BenBergman/replacement_kinesis_controller/bom.md

Note: AliExpress links are often for excess quantities or range of values.

Base parts
----------

- ATmega32U4 - 1
    - [Digikey](http://www.digikey.ca/product-search/en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)
- FFC connectors - 4 vertical or 2 vertical and 2 horizontal for older boards
    - [Digikey (non-stock)](http://www.digikey.ca/product-search/en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)
- MCP23018 - 1
    - [Digikey](http://www.digikey.ca/product-search/en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)
- WS2811 "Neopixels" - 4
- 1N4148 (SOD-323) - 12
    - [Digikey](http://www.digikey.ca/product-detail/en/1N4148W-TP/1N4148WTPMSCT-ND/717311)
    - [AliExpress](http://www.aliexpress.com/item/Free-shipping-100PCS-1N4148-SMD-IN4148-0805-SOD-323-Switching-Diode/1578916085.html)
- LEDs - 4
    - [AliExpress](http://www.aliexpress.com/item/120PC-Lot-0805-SMD-LED-light-Package-LED-Package-Red-White-Green-Blue-Yellow-Orange-0805/2022131094.html)
- PTC resettable fuse - 1
    - [DigiKey](http://www.digikey.ca/product-detail/en/0ZCK0050FF2E/507-1813-1-ND/4156255)
- N-FET (BSS138) - 1
    - [DigiKey](http://www.digikey.ca/product-detail/en/BSS138L/BSS138LCT-ND/5044761)
    - [AliExpress](http://www.aliexpress.com/item/Free-shipping-100PCS-BSS138-BSS138LT1G-ON-SOT-23-MOSFET/840686962.html)
- P-FET (SI2303) - 2
    - [DigiKey](http://www.digikey.ca/product-detail/en/SI2303CDS-T1-GE3/SI2303CDS-T1-GE3CT-ND/1978878)
    - [AliExpress](http://www.aliexpress.com/w/wholesale-si2303.html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)
- Reset switch - 2
    - [Digikey](http://www.digikey.ca/product-detail/en/PTS645SM43SMTR92%20LFS/CKN9112CT-ND/1146934)
    - [AliExpress](http://www.aliexpress.com/item/100pcs-5types-Momentary-Tact-Tactile-Push-Button-Switch-SMD-Assortment-Kit-Set/1868693922.html)
- Power switch - 1
    - [AliExpress](http://www.aliexpress.com/item/SS23E04-G6-8-Solder-Lug-Pin-3-Position-2P3T-DP3T-Panel-Mini-Slide-Switch/1738133706.html)
- 3V3 regulator MIC5504 - 1
    - [DigiKey](http://www.digikey.ca/product-search/en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)

Wireless
--------
- Bluegiga WT12 - 1 - [Digikey](http://www.digikey.ca/product-detail/en/WT12-A-AI5/1446-1011-1-ND/4245494)
- 10nH inductor (0805) - 1
    - [AliExpress](http://www.aliexpress.com/item/Free-Shipping-0805-SMD-Inductor-30valuesX20pcs-600pcs-LOT-1NH-22UH-Electronic-Components-Package-Inductor-Assorted-Ki/1795492501.html)
- JST connector - 1
    - [DigiKey](http://www.digikey.ca/product-detail/en/S2B-PH-SM4-TB%28LF%29%28SN%29/455-1749-1-ND/926846)
- MBR0520LT1 - 1
    - [AliExpress](http://www.aliexpress.com/item/Free-Shipping-50PCS-MBR0520-On-Semi-0-5A-20V-Schottky-SOD-123-MBR0520LT-MBR0520LT1-ICs/1891176479.html)
- MCP73832 (lipo charger) - 1
    - [DigiKey](http://www.digikey.ca/product-detail/en/MCP73832T-2ACI%2FOT/MCP73832T-2ACI%2FOTCT-ND/1979805)
