BenBergman/replacement_kinesis_controller/notes.md

LiPo charger info
* [Using voltage to measure remaining capacity](http://electronics.stackexchange.com/questions/39412/measure-lithium-ion-battery-voltage-thus-remaining-capacity)
* [Bypass battery and charger when external supply present](https://forum.sparkfun.com/viewtopic.php?f=20&t=38033)
* [LiPo regulator discussion](http://electronics.stackexchange.com/questions/38782/regulated-3-3v-from-a-lithium-ion-or-lipo-battery)
