BenBergman/replacement_kinesis_controller/replacement_kinesis_controller.kicad_pcb

## KiCad design replacement_kinesis_controller.kicad_pcb (2015-03-22)

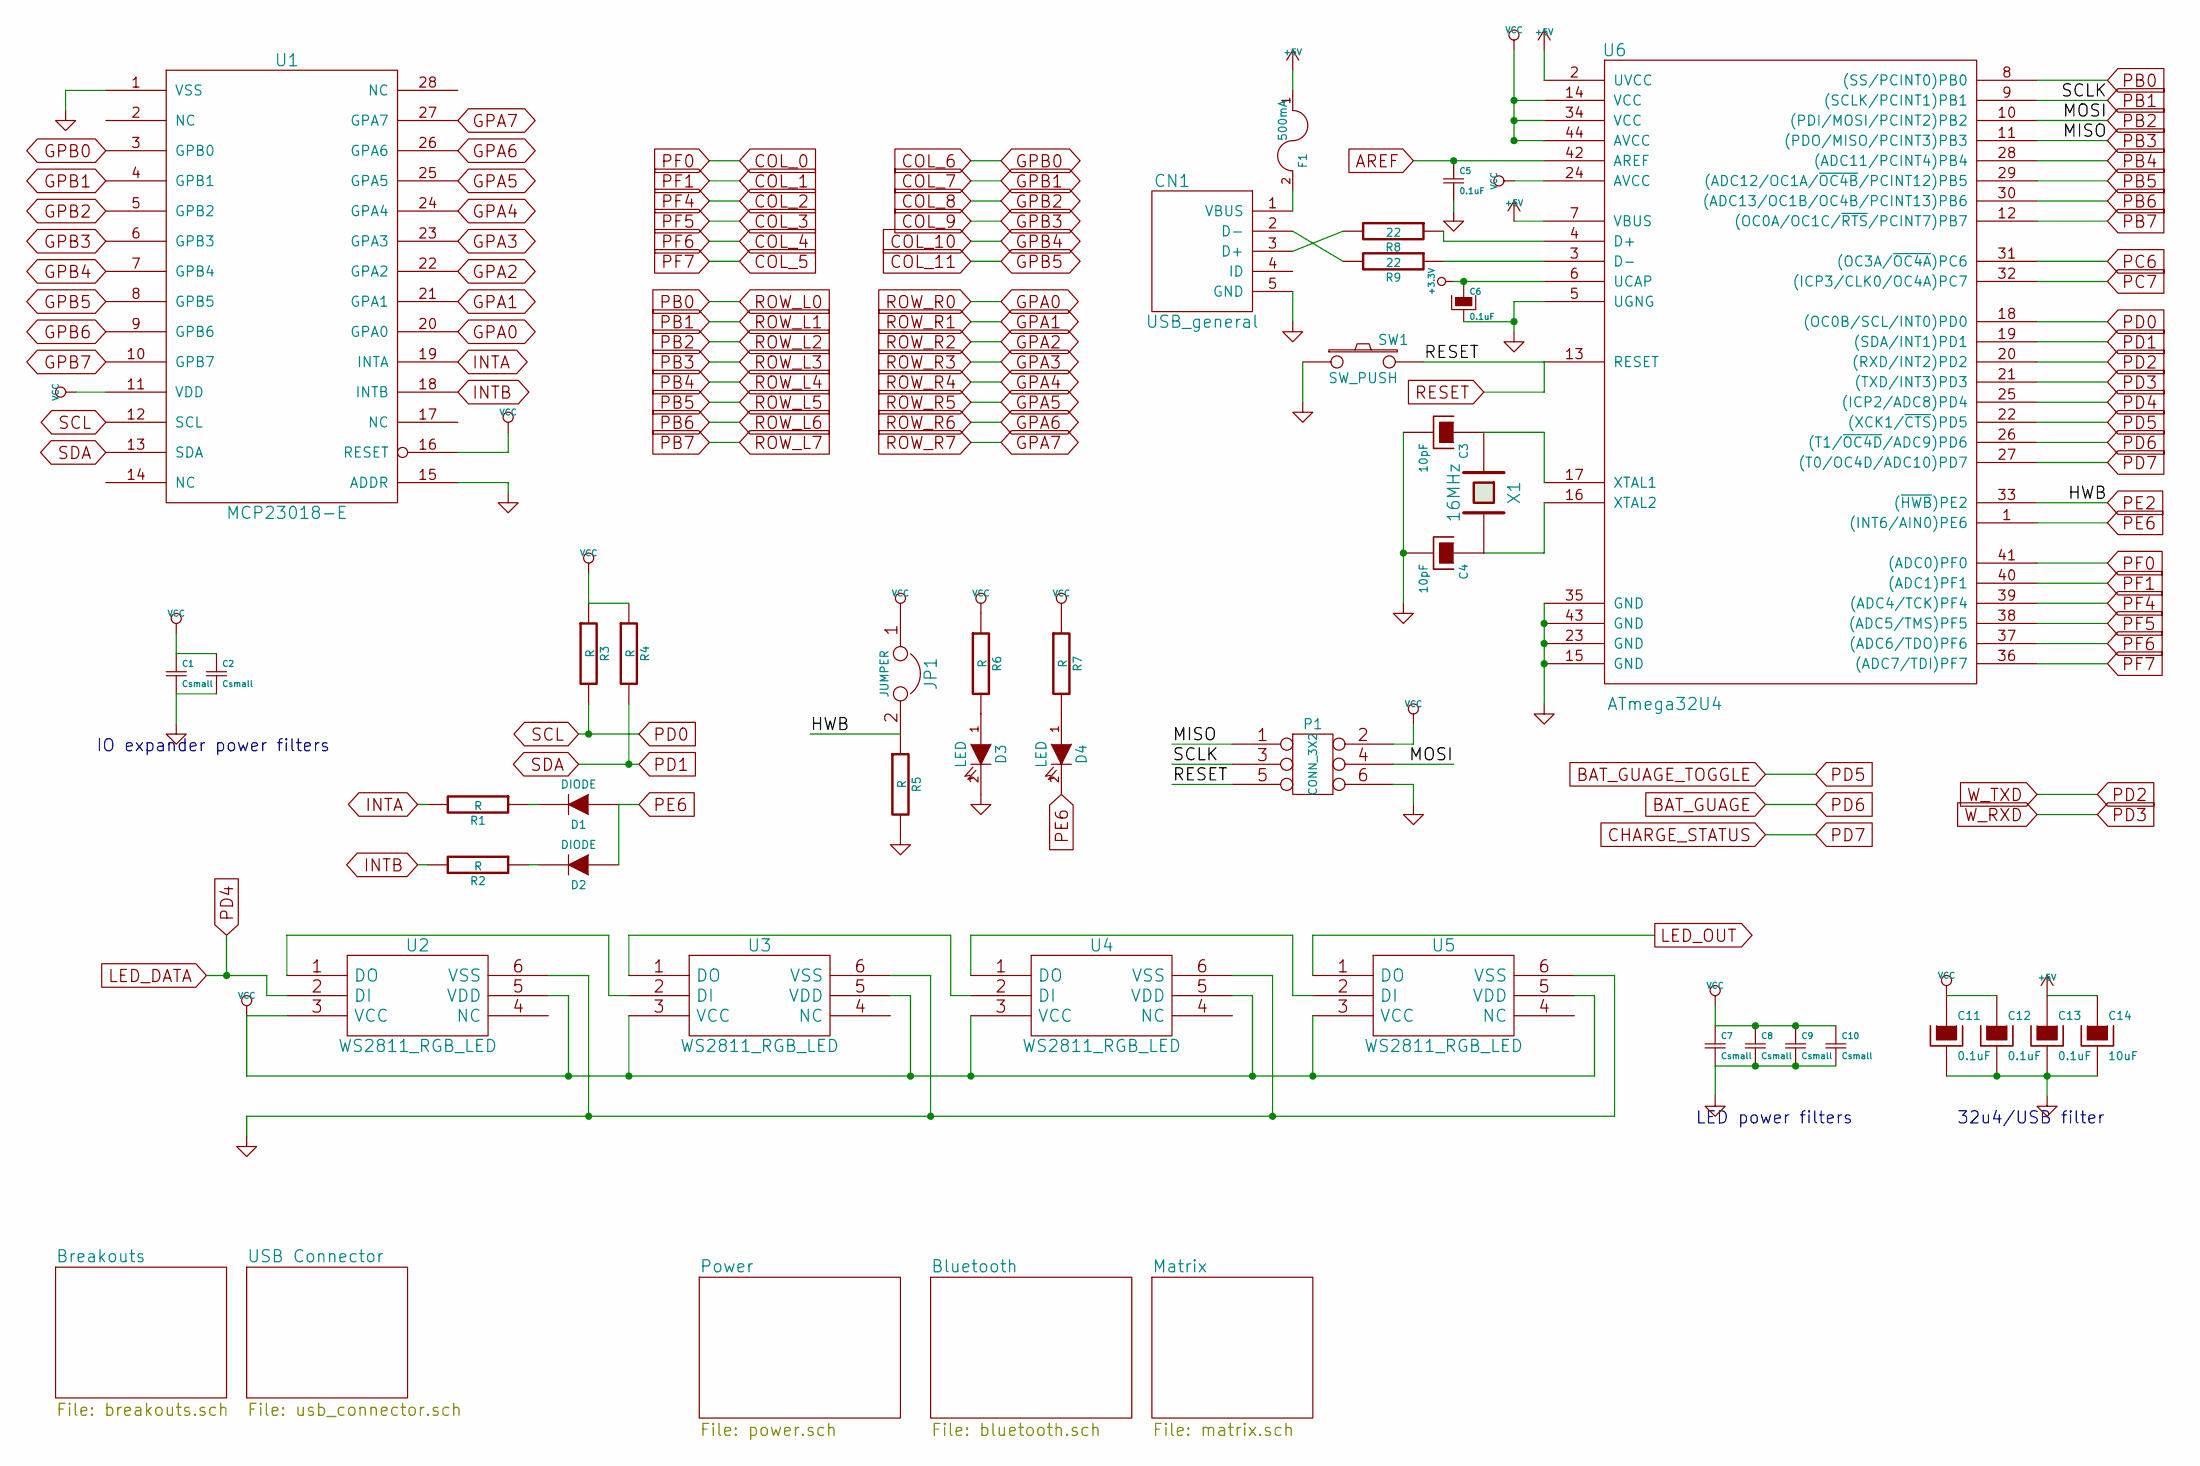
[picture p1: schematic replacement_kinesis_controller.sch, Kinesis Contoured Bluetooth Controller]

Parts:
C1, C2, C7, C8, C9, C10: Csmall; C_0805_HandSoldering
C3, C4: 10pF; C_0805_HandSoldering
C5, C6, C11, C12, C13: 0.1uF; C_0805_HandSoldering
C14: 10uF; C_0805_HandSoldering
CN1: USB_general; Pin_Header_Staggered_Straight_1x05
D1, D2: DIODE; SOD-323_Handsolder
D3, D4: LED; LED-0805
F1: 500mA; R_0805_HandSoldering
JP1: JUMPER; JUMPER_2
P1: CONN_3X2; Pin_Header_Staggered_Straight_2x03
R1, R2, R3, R4, R5, R6, R7: R; R_0805_HandSoldering
R8, R9: 22; R_0805_HandSoldering
SW1: SW_PUSH; SW_SPST_PTS645
U1: MCP23018-E; SOIC-28
U2, U3, U4, U5: WS2811_RGB_LED; LED_RGB_WS2811
U6: ATmega32U4; TQFP-44_10x10mm_Pitch0.8mm
X1: 16MHz; Crystal_HC49-SD_SMD

Connections:
+3.3V: C6.1, U6.6 (UCAP); also elsewhere on the board
+5V: C13.1, C14.1, F1.1, U6.2 (UVCC), U6.7 (VBUS); also elsewhere on the board
AREF: C5.1, U6.42 (AREF); also elsewhere on the board
BAT_GUAGE: U6.26 ((T1/~OC4D~/ADC9)PD6); also elsewhere on the board
BAT_GUAGE_TOGGLE: U6.22 ((XCK1/~CTS~)PD5); also elsewhere on the board
COL_0: U6.41 ((ADC0)PF0); also elsewhere on the board
COL_2: U6.39 ((ADC4/TCK)PF4); also elsewhere on the board
COL_5: U6.36 ((ADC7/TDI)PF7); also elsewhere on the board
COL_6: U1.3 (GPB0); also elsewhere on the board
COL_7: U1.4 (GPB1); also elsewhere on the board
COL_8: U1.5 (GPB2); also elsewhere on the board
COL_11: U1.8 (GPB5); also elsewhere on the board
GND: C1.2, C2.2, C3.2, C4.2, C5.2, C6.2, C7.2, C8.2, C9.2, C10.2, C11.2, C12.2, C13.2, C14.2, CN1.5 (GND), D3.2 (K), P1.6, R5.2, SW1.1, U1.1 (VSS), U1.15 (ADDR), U2.6 (VSS), U3.6 (VSS), U4.6 (VSS), U5.6 (VSS), U6.5 (UGNG), U6.15 (GND), U6.23 (GND), U6.35 (GND), U6.43 (GND); also elsewhere on the board
GPA3: U1.23 (GPA3); also elsewhere on the board
GPA5: U1.25 (GPA5); also elsewhere on the board
GPA6: U1.26 (GPA6); also elsewhere on the board
GPA7: U1.27 (GPA7); also elsewhere on the board
GPB3: U1.6 (GPB3); also elsewhere on the board
GPB4: U1.7 (GPB4); also elsewhere on the board
GPB6: U1.9 (GPB6); also elsewhere on the board
GPB7: U1.10 (GPB7); also elsewhere on the board
INTA: R1.2, U1.19 (INTA)
INTB: R2.2, U1.18 (INTB)
LED_OUT: U5.1 (DO); also elsewhere on the board
unnamed: C3.1, U6.17 (XTAL1), X1.1
unnamed: C4.1, U6.16 (XTAL2), X1.2
unnamed: CN1.1 (VBUS), F1.2
unnamed: CN1.2 (D-), R9.2
unnamed: CN1.3 (D+), R8.2
unnamed: D1.2 (K), R1.1
unnamed: D2.2 (K), R2.1
unnamed: D3.1 (A), R6.2
unnamed: D4.1 (A), R7.2
unnamed: R8.1, U6.4 (D+)
unnamed: R9.1, U6.3 (D-)
unnamed: U2.1 (DO), U3.2 (DI)
unnamed: U3.1 (DO), U4.2 (DI)
unnamed: U4.1 (DO), U5.2 (DI)
PB1: P1.3, U6.9 ((SCLK/PCINT1)PB1); also elsewhere on the board
PB2: P1.4, U6.10 ((PDI/MOSI/PCINT2)PB2); also elsewhere on the board
PB3: P1.1, U6.11 ((PDO/MISO/PCINT3)PB3); also elsewhere on the board
PB4: U6.28 ((ADC11/PCINT4)PB4); also elsewhere on the board
PB5: U6.29 ((ADC12/OC1A/~OC4B~/PCINT12)PB5); also elsewhere on the board
PB6: U6.30 ((ADC13/OC1B/OC4B/PCINT13)PB6); also elsewhere on the board
PB7: U6.12 ((OC0A/OC1C/~RTS~/PCINT7)PB7); also elsewhere on the board
PC6: U6.31 ((OC3A/~OC4A~)PC6); also elsewhere on the board
PC7: U6.32 ((ICP3/CLK0/OC4A)PC7); also elsewhere on the board
PD0: R3.2, U1.12 (SCL), U6.18 ((OC0B/SCL/INT0)PD0); also elsewhere on the board
PD3: U6.21 ((TXD/INT3)PD3); also elsewhere on the board
PD7: U6.27 ((T0/OC4D/ADC10)PD7); also elsewhere on the board
PE2: JP1.2, R5.1, U6.33 ((~HWB~)PE2)
PE6: D1.1 (A), D2.1 (A), D4.2 (K), U6.1 ((INT6/AIN0)PE6); also elsewhere on the board
PF1: U6.40 ((ADC1)PF1); also elsewhere on the board
PF5: U6.38 ((ADC5/TMS)PF5); also elsewhere on the board
PF6: U6.37 ((ADC6/TDO)PF6); also elsewhere on the board
RESET: P1.5, SW1.2, U6.13 (RESET); also elsewhere on the board
ROW_L0: U6.8 ((SS/PCINT0)PB0); also elsewhere on the board
ROW_R0: U1.20 (GPA0); also elsewhere on the board
ROW_R1: U1.21 (GPA1); also elsewhere on the board
ROW_R2: U1.22 (GPA2); also elsewhere on the board
ROW_R4: U1.24 (GPA4); also elsewhere on the board
SDA: R4.2, U1.13 (SDA), U6.19 ((SDA/INT1)PD1); also elsewhere on the board
VCC: C1.1, C2.1, C7.1, C8.1, C9.1, C10.1, C11.1, C12.1, JP1.1, P1.2, R3.1, R4.1, R6.1, R7.1, U1.11 (VDD), U1.16 (RESET), U2.3 (VCC), U2.5 (VDD), U3.3 (VCC), U3.5 (VDD), U4.3 (VCC), U4.5 (VDD), U5.3 (VCC), U5.5 (VDD), U6.14 (VCC), U6.24 (AVCC), U6.34 (VCC), U6.44 (AVCC); also elsewhere on the board
W_TXD: U6.20 ((RXD/INT2)PD2); also elsewhere on the board

Notes on the sheet:
32u4/USB filter
LED power filters
IO expander power filters

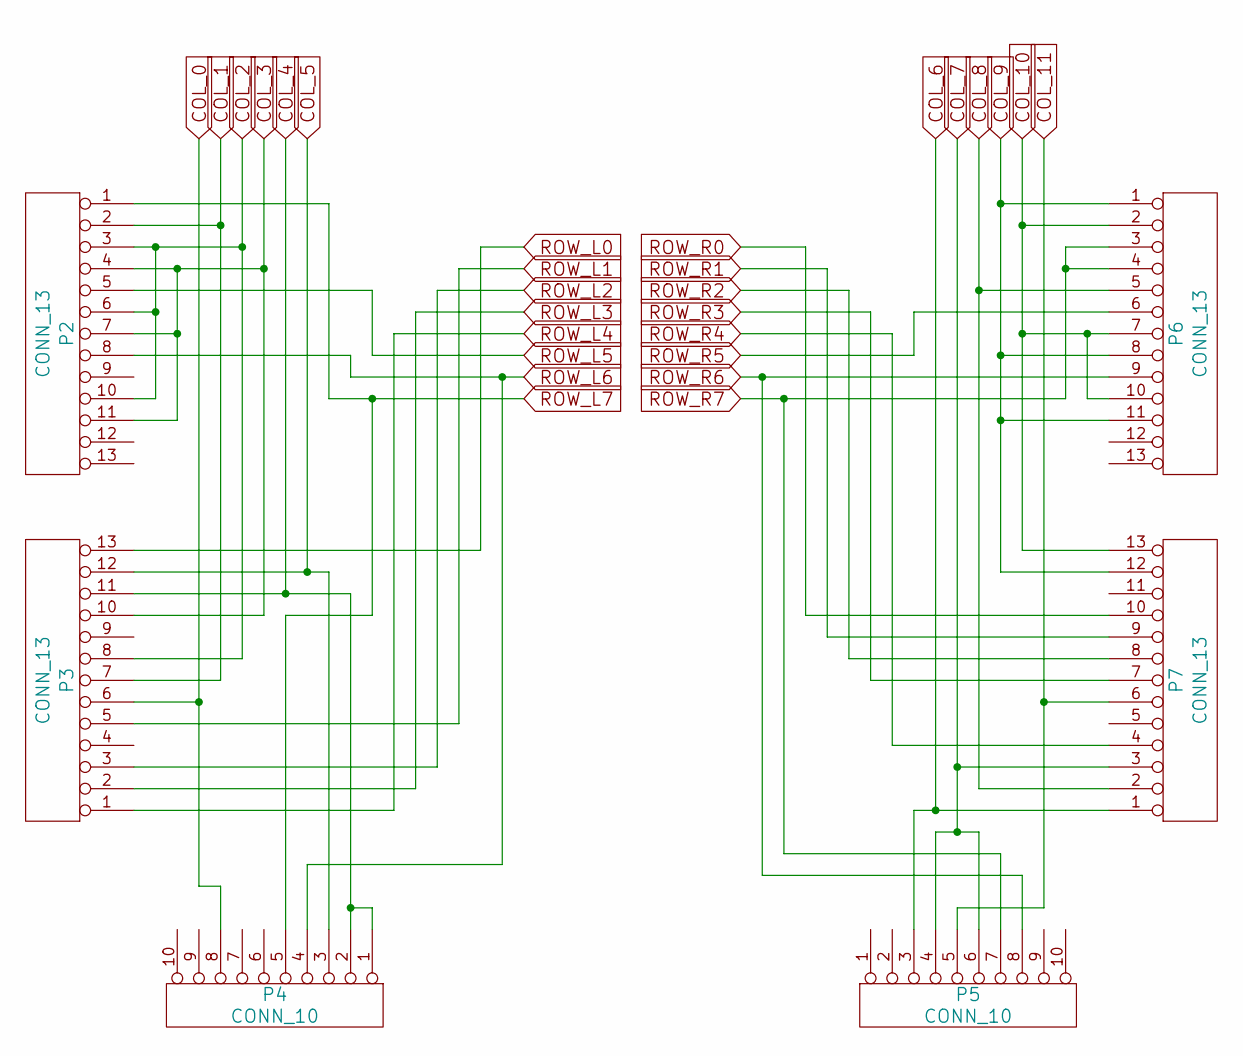
[picture p2: schematic matrix.sch, Kinesis Contoured Bluetooth Controller]

Parts:
P2, P7: CONN_13; Molex_FFC_13_mirror
P3, P6: CONN_13; Molex_FFC_13
P4, P5: CONN_10; Pin_Header_Staggered_Straight_1x10

Connections:
COL_0: P3.6, P4.8; also elsewhere on the board
COL_2: P2.3, P2.6, P2.10, P3.8; also elsewhere on the board
COL_5: P3.12, P4.3; also elsewhere on the board
COL_6: P5.3, P7.1; also elsewhere on the board
COL_7: P5.4, P5.6, P7.3; also elsewhere on the board
COL_8: P6.5, P7.2; also elsewhere on the board
COL_11: P5.5, P7.6; also elsewhere on the board
GPA3: P7.7; also elsewhere on the board
GPA5: P6.6; also elsewhere on the board
GPA6: P5.8, P6.9; also elsewhere on the board
GPA7: P5.7, P6.3, P6.4; also elsewhere on the board
GPB3: P6.1, P6.8, P6.11, P7.12; also elsewhere on the board
GPB4: P6.2, P6.7, P6.10, P7.13; also elsewhere on the board
PB1: P3.5; also elsewhere on the board
PB2: P3.3; also elsewhere on the board
PB3: P3.2; also elsewhere on the board
PB4: P3.1; also elsewhere on the board
PB5: P2.5; also elsewhere on the board
PB6: P2.8, P4.4; also elsewhere on the board
PB7: P2.1, P4.5; also elsewhere on the board
PF1: P2.2, P3.7; also elsewhere on the board
PF5: P2.4, P2.7, P2.11, P3.10; also elsewhere on the board
PF6: P3.11, P4.1, P4.2; also elsewhere on the board
ROW_L0: P3.13; also elsewhere on the board
ROW_R0: P7.10; also elsewhere on the board
ROW_R1: P7.9; also elsewhere on the board
ROW_R2: P7.8; also elsewhere on the board
ROW_R4: P7.4; also elsewhere on the board

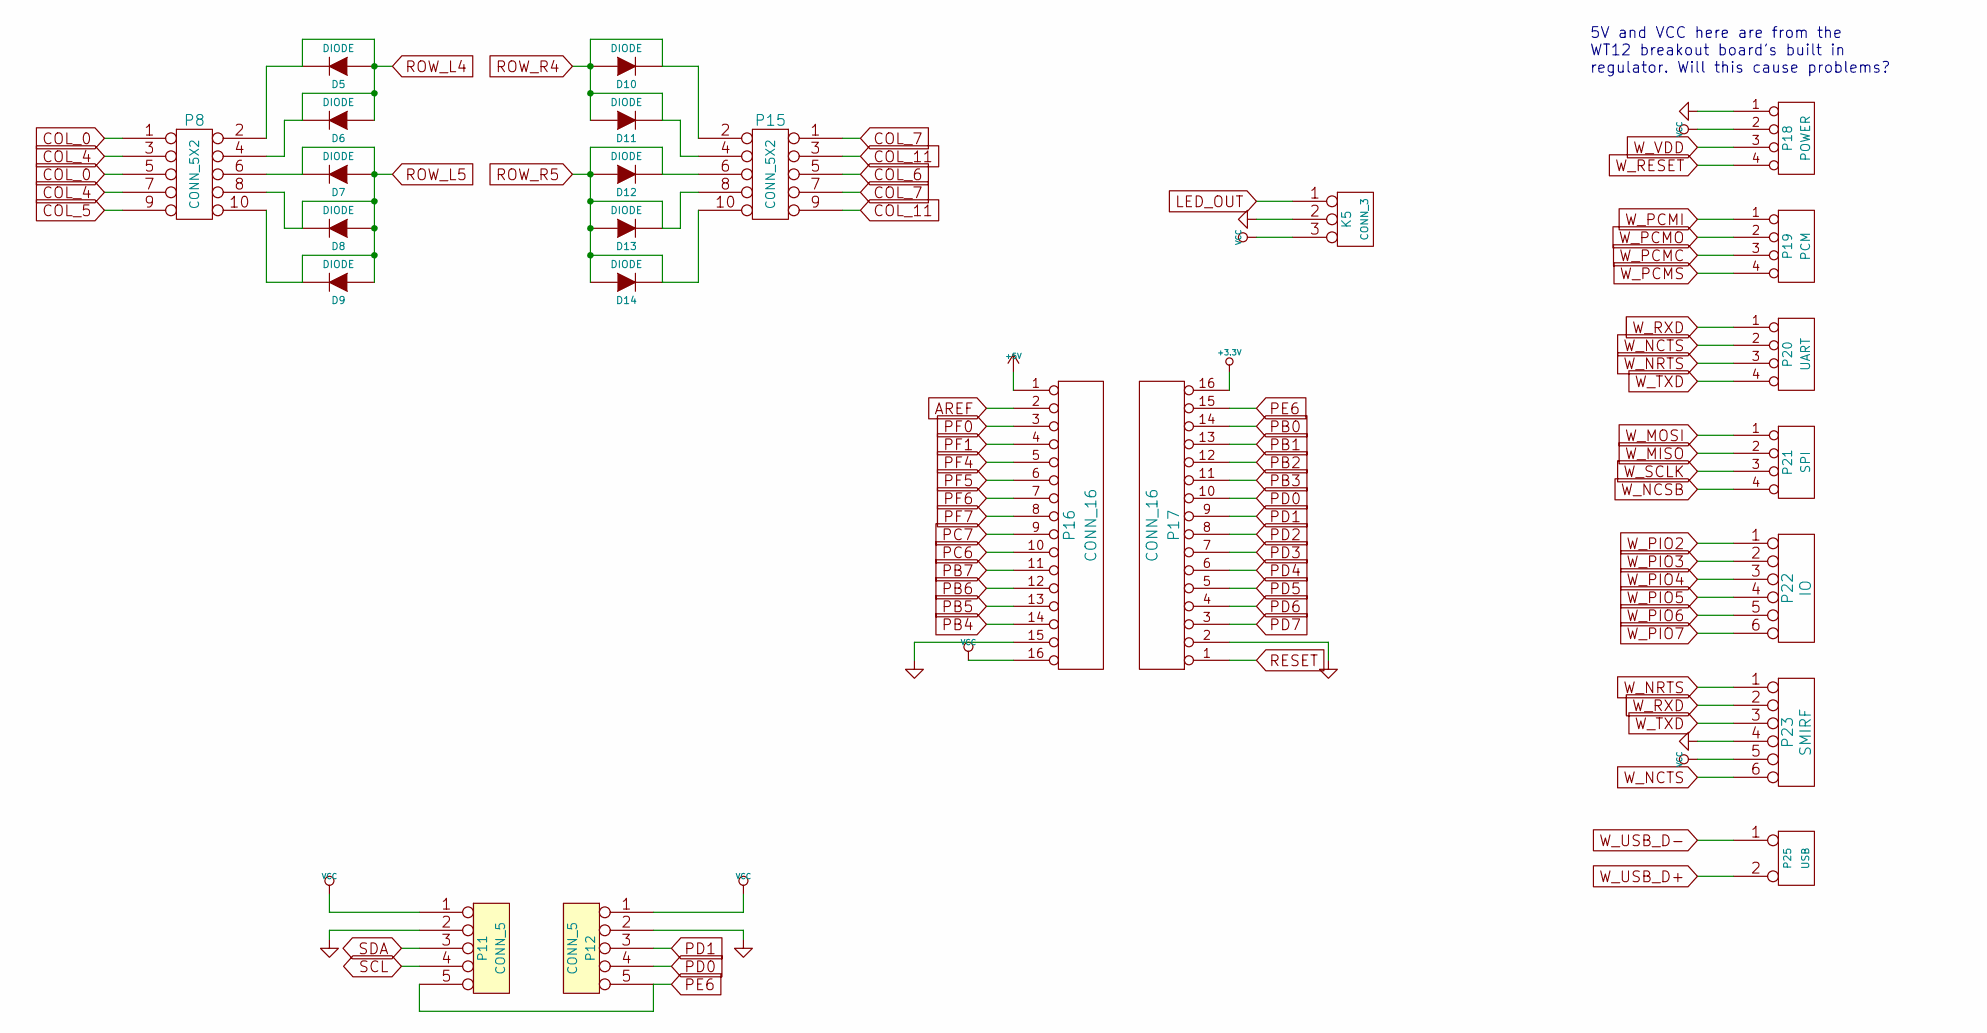
[picture p3: schematic breakouts.sch, Kinesis Contoured Bluetooth Controller]

Parts:
D5, D6, D7, D8, D9, D10, D11, D12, D13, D14: DIODE; SOD-323_Handsolder
K5: CONN_3; Pin_Header_Staggered_Straight_1x03
P8, P15: CONN_5X2; Pin_Header_Staggered_Straight_2x05
P11, P12: CONN_5; Pin_Header_Staggered_Straight_1x05
P16, P17: CONN_16; Pin_Header_Staggered_Straight_1x16
P18: POWER; Pin_Header_Staggered_Straight_1x04
P19: PCM; Pin_Header_Staggered_Straight_1x04
P20: UART; Pin_Header_Staggered_Straight_1x04
P21: SPI; Pin_Header_Staggered_Straight_1x04
P22: IO; Pin_Header_Staggered_Straight_1x06
P23: SMIRF; Pin_Header_Staggered_Straight_1x06
P25: USB; Pin_Header_Staggered_Straight_1x02

Connections:
+3.3V: P17.16; also elsewhere on the board
+5V: P16.1; also elsewhere on the board
AREF: P16.2; also elsewhere on the board
BAT_GUAGE: P17.4; also elsewhere on the board
BAT_GUAGE_TOGGLE: P17.5; also elsewhere on the board
COL_0: P8.1, P8.5, P16.3; also elsewhere on the board
COL_2: P16.5; also elsewhere on the board
COL_5: P8.9, P16.8; also elsewhere on the board
COL_6: P15.5; also elsewhere on the board
COL_7: P15.1, P15.7; also elsewhere on the board
COL_11: P15.3, P15.9; also elsewhere on the board
GND: K5.2 (PM), P11.2, P12.2, P16.15, P17.2, P18.1, P23.4; also elsewhere on the board
GPA5: D12.1 (A), D12.2 (K), D13.1 (A), D13.2 (K), D14.1 (A), D14.2 (K), P15.6, P15.8, P15.10; also elsewhere on the board
PB1: P17.13; also elsewhere on the board
PB2: P17.12; also elsewhere on the board
PB3: P17.11; also elsewhere on the board
PB4: D5.1 (A), D5.2 (K), D6.1 (A), D6.2 (K), P8.2, P8.4, P16.14; also elsewhere on the board
PB5: D7.1 (A), D7.2 (K), D8.1 (A), D8.2 (K), D9.1 (A), D9.2 (K), P8.6, P8.8, P8.10, P16.13; also elsewhere on the board
PB6: P16.12; also elsewhere on the board
PB7: P16.11; also elsewhere on the board
PC6: P16.10; also elsewhere on the board
PC7: P16.9; also elsewhere on the board
PD0: P11.4, P12.4, P17.10; also elsewhere on the board
PD3: P17.7, P20.1, P23.2; also elsewhere on the board
PD7: P17.3; also elsewhere on the board
PE6: P11.5, P12.5, P17.15; also elsewhere on the board
PF1: P16.4; also elsewhere on the board
PF5: P16.6; also elsewhere on the board
PF6: P8.3, P8.7, P16.7; also elsewhere on the board
RESET: P17.1; also elsewhere on the board
ROW_L0: P17.14; also elsewhere on the board
ROW_R4: D10.1 (A), D10.2 (K), D11.1 (A), D11.2 (K), P15.2, P15.4; also elsewhere on the board
SDA: P11.3, P12.3, P17.9; also elsewhere on the board
VCC: K5.3, P11.1, P12.1, P16.16, P18.2, P23.5; also elsewhere on the board
W_MISO: P21.2; also elsewhere on the board
W_MOSI: P21.1; also elsewhere on the board
W_NCSB: P21.4; also elsewhere on the board
W_NCTS: P20.2, P23.6; also elsewhere on the board
W_NRTS: P20.3, P23.1; also elsewhere on the board
W_PCMC: P19.3; also elsewhere on the board
W_PCMI: P19.1; also elsewhere on the board
W_PCMO: P19.2; also elsewhere on the board
W_PCMS: P19.4; also elsewhere on the board
W_PIO2: P22.1; also elsewhere on the board
W_PIO3: P22.2; also elsewhere on the board
W_PIO4: P22.3; also elsewhere on the board
W_PIO5: P22.4; also elsewhere on the board
W_PIO6: P22.5; also elsewhere on the board
W_PIO7: P22.6; also elsewhere on the board
W_RESET: P18.4; also elsewhere on the board
W_SCLK: P21.3; also elsewhere on the board
W_TXD: P17.8, P20.4, P23.3; also elsewhere on the board
W_USB_D+: P25.2 (PM); also elsewhere on the board
W_USB_D-: P25.1; also elsewhere on the board
W_VDD: P18.3; also elsewhere on the board

Notes on the sheet:
5V and VCC here are from the WT12 breakout board's built in regulator. Will this cause problems?

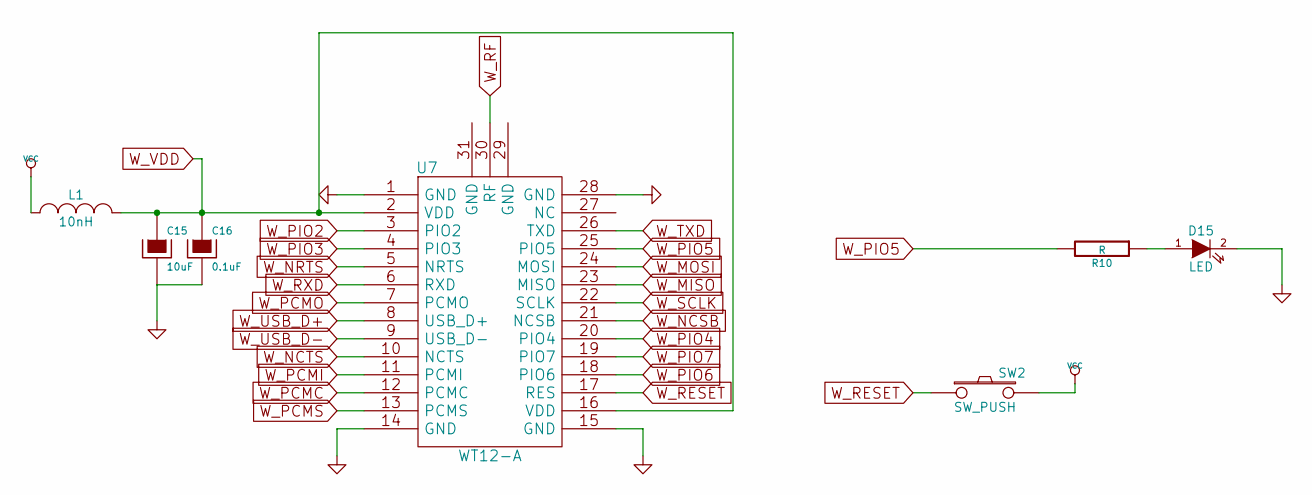
[picture p4: schematic bluetooth.sch, Kinesis Contoured Bluetooth Controller]

Parts:
C15: 10uF; C_0805_HandSoldering
C16: 0.1uF; C_0805_HandSoldering
D15: LED; LED-0805
L1: 10nH; R_0805_HandSoldering
R10: R; R_0805_HandSoldering
SW2: SW_PUSH; SW_SPST_PTS645
U7: WT12-A; WT12

Connections:
GND: C15.2, C16.2, D15.2 (K), U7.1 (GND), U7.14 (GND), U7.15 (GND), U7.28 (GND); also elsewhere on the board
unnamed: D15.1 (A), R10.1
PD3: U7.6 (RXD); also elsewhere on the board
VCC: L1.1, SW2.2; also elsewhere on the board
W_MISO: U7.23 (MISO); also elsewhere on the board
W_MOSI: U7.24 (MOSI); also elsewhere on the board
W_NCSB: U7.21 (NCSB); also elsewhere on the board
W_NCTS: U7.10 (NCTS); also elsewhere on the board
W_NRTS: U7.5 (NRTS); also elsewhere on the board
W_PCMC: U7.12 (PCMC); also elsewhere on the board
W_PCMI: U7.11 (PCMI); also elsewhere on the board
W_PCMO: U7.7 (PCMO); also elsewhere on the board
W_PCMS: U7.13 (PCMS); also elsewhere on the board
W_PIO2: U7.3 (PIO2); also elsewhere on the board
W_PIO3: U7.4 (PIO3); also elsewhere on the board
W_PIO4: U7.20 (PIO4); also elsewhere on the board
W_PIO5: R10.2, U7.25 (PIO5); also elsewhere on the board
W_PIO6: U7.18 (PIO6); also elsewhere on the board
W_PIO7: U7.19 (PIO7); also elsewhere on the board
W_RESET: SW2.1, U7.17 (RES); also elsewhere on the board
W_RF: U7.30 (RF)
W_SCLK: U7.22 (SCLK); also elsewhere on the board
W_TXD: U7.26 (TXD); also elsewhere on the board
W_USB_D+: U7.8 (USB_D+); also elsewhere on the board
W_USB_D-: U7.9 (USB_D-); also elsewhere on the board
W_VDD: C15.1, C16.1, L1.2, U7.2 (VDD), U7.16 (VDD); also elsewhere on the board

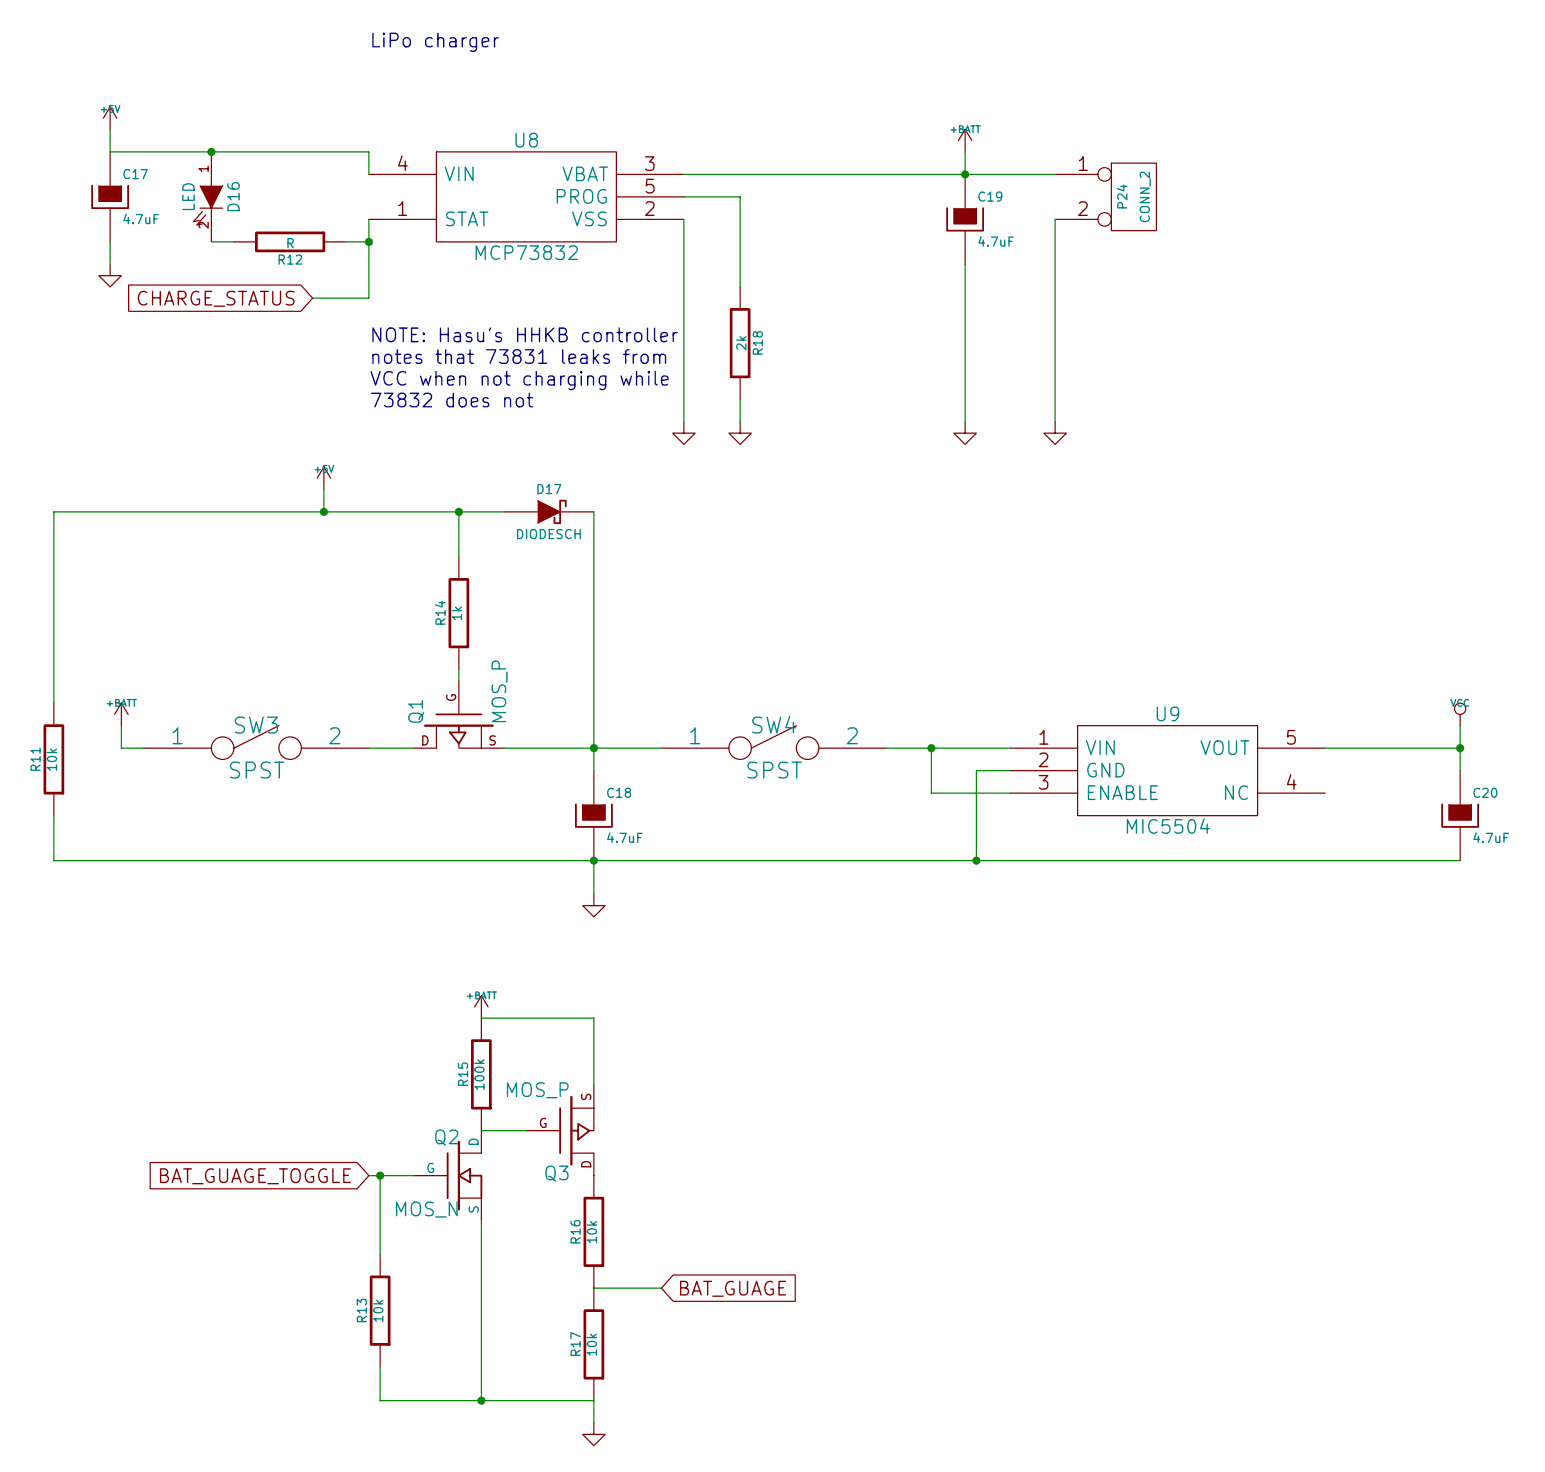
[picture p5: schematic power.sch, Kinesis Contoured Bluetooth Controller]

Parts:
C17, C18, C19, C20: 4.7uF; C_0805_HandSoldering
D16: LED; LED-0805
D17: DIODESCH; SOD-123_Handsolder
P24: CONN_2; JST-2
Q1, Q3: MOS_P; SOT23_Handsoldering
Q2: MOS_N; SOT23_Handsoldering
R11, R13, R16, R17: 10k; R_0805_HandSoldering
R12: R; R_0805_HandSoldering
R14: 1k; R_0805_HandSoldering
R15: 100k; R_0805_HandSoldering
R18: 2k; R_0805_HandSoldering
SW3, SW4: SPST; Pin_Header_Staggered_Straight_1x02
U8: MCP73832; SOT23-5_handsolder
U9: MIC5504; SOT23-5_handsolder

Connections:
+5V: C17.1, D16.1 (A), D17.1 (A), R11.2, R14.2, U8.4 (VIN); also elsewhere on the board
+BATT: C19.1, P24.1, Q3.S, R15.2, SW3.1, U8.3 (VBAT)
BAT_GUAGE: R16.1, R17.2; also elsewhere on the board
BAT_GUAGE_TOGGLE: Q2.G, R13.2; also elsewhere on the board
GND: C17.2, C18.2, C19.2, C20.2, P24.2 (PM), Q2.S, R11.1, R13.1, R17.1, R18.2, U8.2 (VSS), U9.2 (GND); also elsewhere on the board
unnamed: C18.1, D17.2 (K), Q1.S, SW4.1
unnamed: D16.2 (K), R12.2
unnamed: Q1.D, SW3.2
unnamed: Q1.G, R14.1
unnamed: Q2.D, Q3.G, R15.1
unnamed: Q3.D, R16.2
unnamed: R18.1, U8.5 (PROG)
unnamed: SW4.2, U9.1 (VIN), U9.3 (ENABLE)
PD7: R12.1, U8.1 (STAT); also elsewhere on the board
VCC: C20.1, U9.5 (VOUT); also elsewhere on the board

Notes on the sheet:
LiPo charger
NOTE: Hasu's HHKB controller notes that 73831 leaks from VCC when not charging while 73832 does not

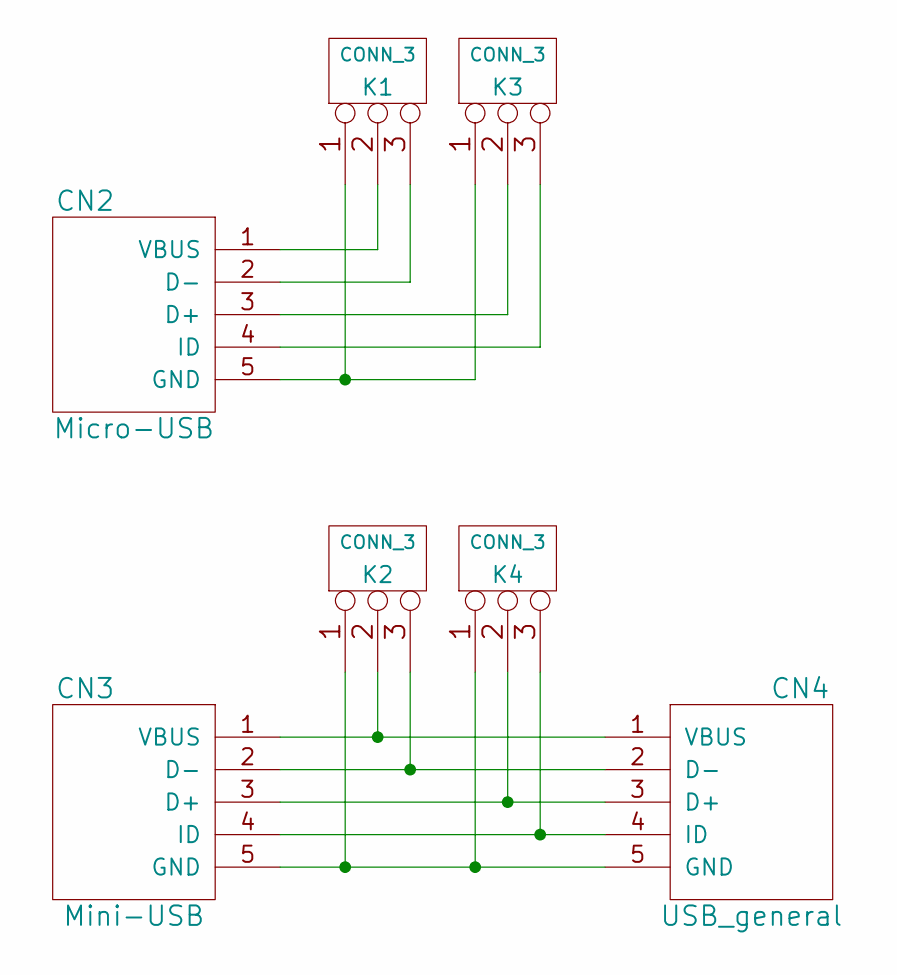
[picture p6: schematic usb_connector.sch, Kinesis Contoured Bluetooth Controller]

Parts:
CN2: Micro-USB; USB_micro_B-vertical
CN3: Mini-USB; USB_mini_B-vertical
CN4: USB_general; Pin_Header_Staggered_Straight_1x05
K1, K2, K3, K4: CONN_3; Pin_Header_Staggered_Straight_1x03

Connections:
unnamed: CN2.1 (VBUS), K1.2 (PM)
unnamed: CN2.2 (D-), K1.3
unnamed: CN2.3 (D+), K3.2 (PM)
unnamed: CN2.4 (ID), K3.3
unnamed: CN2.5 (GND), K1.1, K3.1
unnamed: CN3.1 (VBUS), CN4.1 (VBUS), K2.2 (PM)
unnamed: CN3.2 (D-), CN4.2 (D-), K2.3
unnamed: CN3.3 (D+), CN4.3 (D+), K4.2 (PM)
unnamed: CN3.4 (ID), CN4.4 (ID), K4.3
unnamed: CN3.5 (GND), CN4.5 (GND), K2.1, K4.1

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
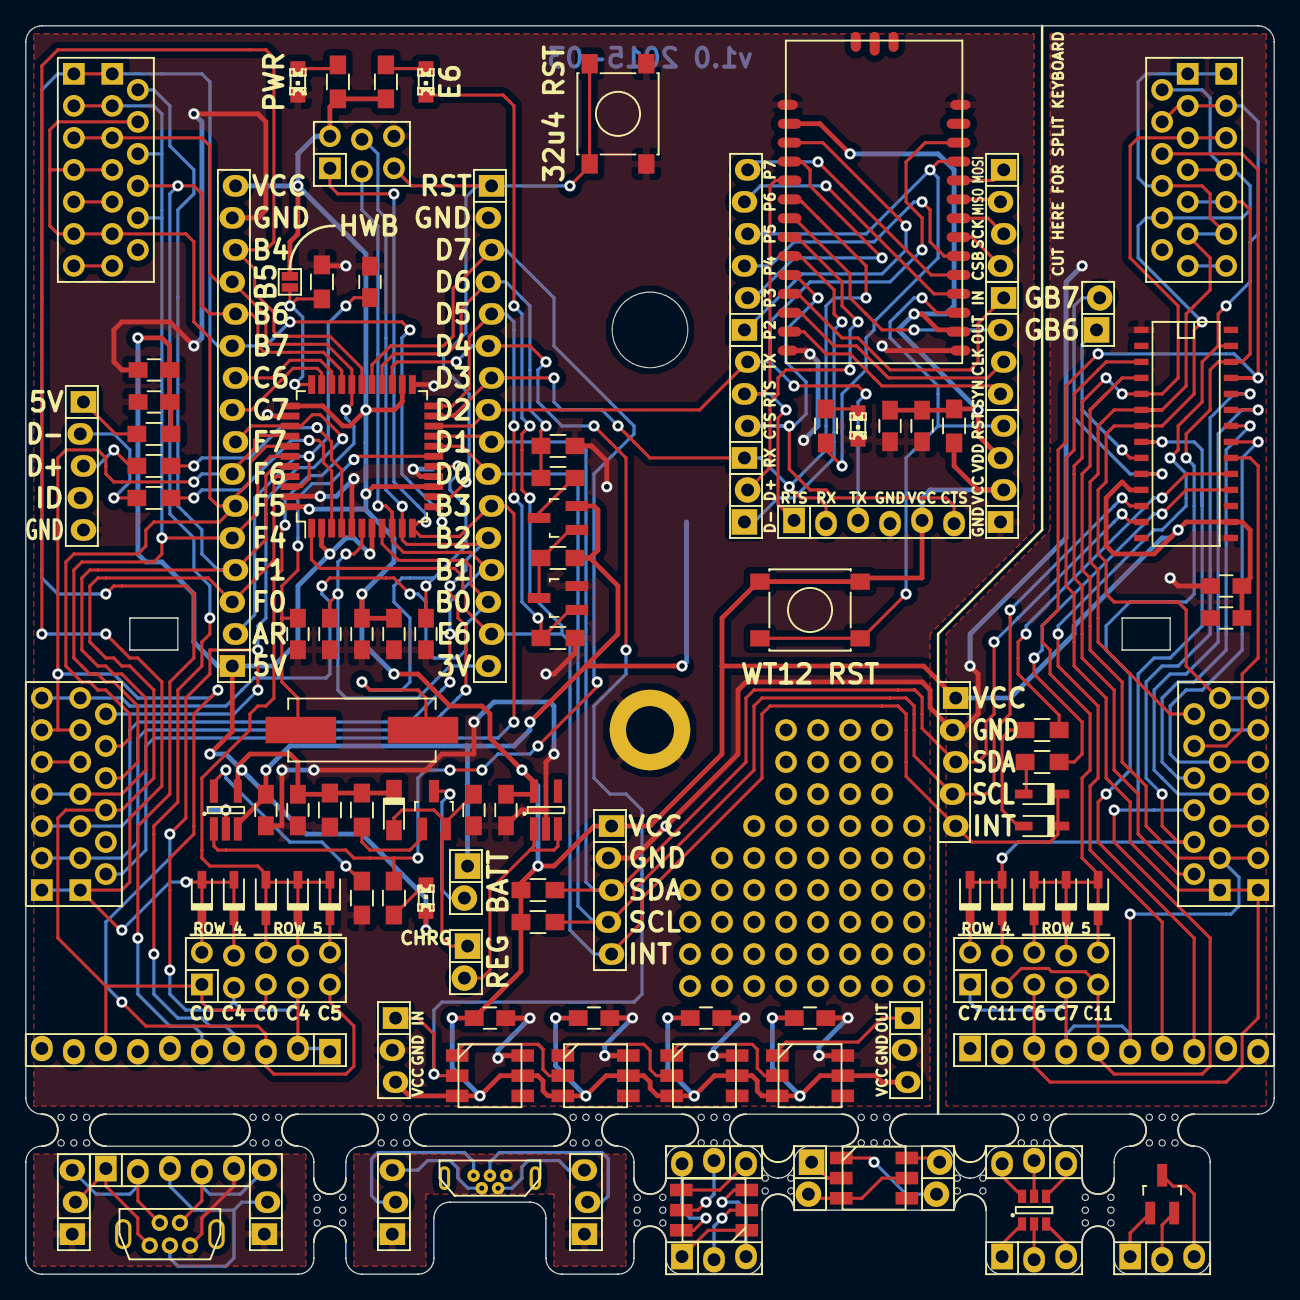
[picture p7: board replacement_kinesis_controller.kicad_pcb from above]

Board: 2 copper layers, 99.1 x 99.1 mm, 118 parts (1 on the bottom side), 105 nets.

Other parts of the board:
K5#2: CONN_3; Pin_Header_Staggered_Straight_1x03
MountingHole_6mm: VAL**; MountingHole_6mm
Pin_Header_Staggered_Straight_1x02, Pin_Header_Staggered_Straight_1x02#2, Pin_Header_Staggered_Straight_1x02#3: VAL**; Pin_Header_Staggered_Straight_1x02
Pin_Header_Staggered_Straight_1x03, Pin_Header_Staggered_Straight_1x03#2, Pin_Header_Staggered_Straight_1x03#3, Pin_Header_Staggered_Straight_1x03#4, Pin_Header_Staggered_Straight_1x03#5: VAL**; Pin_Header_Staggered_Straight_1x03
Pin_Header_Straight_1x01: VAL**; Plated_Mounting_Hole
SOT23-6_1: VAL**; SOT23-6
SOT-23_HandSoldering: VAL**; SOT-23_Handsoldering

Their connections:
GND: K5#2.2, Pin_Header_Straight_1x01.1; also elsewhere on the board
GPB6: Pin_Header_Staggered_Straight_1x02#3.1; also elsewhere on the board
GPB7: Pin_Header_Staggered_Straight_1x02#3.2; also elsewhere on the board
LED_OUT: K5#2.1; also elsewhere on the board
VCC: K5#2.3; also elsewhere on the board
