BenBergman/replacement_kinesis_controller/(commit log)

2014-12-10 Updated schematic with matrix info
    [replacement_kinesis_controller.sch]
2015-01-28 Fix up right function key matrix
    [replacement_kinesis_controller.sch]
2015-01-29 Add value and extras for 32u4 breakout schematic
    [replacement_kinesis_controller.sch]
2015-01-30 Add IO expander
    [replacement_kinesis_controller.sch]
2015-01-30 Add matrix to IO map
    [replacement_kinesis_controller.sch]
2015-02-02 Add lipo charging circuitry
    [replacement_kinesis_controller.sch]
2015-02-02 Add battery connector (should be JST connector)
    [replacement_kinesis_controller.sch]
2015-02-03 Add WT12 symbol
    [replacement_kinesis_controller.sch]
2015-02-03 Add all bluetooth headers
    [replacement_kinesis_controller.sch]
2015-02-06 More stuff, including LEDs
    [replacement_kinesis_controller.sch]
2015-02-07 Add some connections and many headers
    [replacement_kinesis_controller.sch]
2015-02-07 Connect ATmega to WT12
    [replacement_kinesis_controller.sch]
2015-02-07 Reorganize and fix USB breakout
    [replacement_kinesis_controller.sch]
2015-02-07 Add battery guage circuitry
    [replacement_kinesis_controller.sch]
2015-02-07 Add voltage regulation
    [replacement_kinesis_controller.sch]
2015-02-08 Add breakouts for empty sections of switch matrix
    [replacement_kinesis_controller.sch]
2015-02-12 Add pull up resistors to i2c line (TWCR wait loop stuck otherwise)
    [replacement_kinesis_controller.sch]
2015-02-14 Add note about lipo stuff
2015-02-18 Fix right function keys wiring
    [replacement_kinesis_controller.sch]
2015-02-18 Restructure some things into sheets
    [breakouts.sch, matrix.sch, replacement_kinesis_controller.sch]
2015-02-18 Fix new VCC pin to use power symbol
    [breakouts.sch]
2015-02-19 Sort remaining sections to sheets
    [bluetooth.sch, breakouts.sch, matrix.sch, power.sch, replacement_kinesis_controller.sch]
2015-02-20 Assign RGB LEDs a pin
    [replacement_kinesis_controller.sch]
2015-02-20 Add power filters for LEDs
    [replacement_kinesis_controller.sch]
2015-02-20 Move some stuff around and add reset button to WT12
    [bluetooth.sch, breakouts.sch, matrix.sch, power.sch, replacement_kinesis_controller.sch]
2015-02-20 Switch LEDs to another pin to free the remaining interrupt pin
    [replacement_kinesis_controller.sch]
2015-02-20 Add MCP23018 interrupt connections
    [breakouts.sch, replacement_kinesis_controller.sch]
2015-02-20 Correct diode polarity for external switches
    [breakouts.sch]
2015-02-21 Add power switch
    [power.sch]
2015-02-21 Add connections from battery monitoring circuitry to 32u4
    [power.sch, replacement_kinesis_controller.sch]
2015-02-21 Add capacitor to AREF line, similar to Hasu's controller
    [replacement_kinesis_controller.sch]
2015-02-21 Switch HWB to a pull down and open jumper to hopefully reduce power consumption
    [replacement_kinesis_controller.sch]
2015-02-21 Move Bluetooth wire assignment to front sheet
    [bluetooth.sch, replacement_kinesis_controller.sch]
2015-02-21 Change voltage source auto switch over circuitry to match Hasu's
    [power.sch]
2015-02-21 Correct circuit for battery monitoring
    [power.sch]
2015-02-21 Add pull-down resistor to bat gauge circuit to match Hasu's
    [power.sch]
2015-02-21 Add secondary power switch location
    [power.sch]
2015-02-21 Add note about bluetooth power breakout
    [breakouts.sch]
2015-02-21 Add PIO5 LED to WT12 circuit like the breakoutboard has
    [bluetooth.sch]
2015-02-21 Update sheet fields
    [bluetooth.sch, breakouts.sch, matrix.sch, power.sch, replacement_kinesis_controller.sch]
2015-02-21 Add missing usb connector sheet
    [usb_connector.sch]
2015-02-22 Add a whole bunch of new footprints
2015-02-22 Add start of pcb layout (mounting points and netlist import)
    [replacement_kinesis_controller.kicad_pcb]
2015-02-22 Add annotations to parts
    [bluetooth.sch, breakouts.sch, matrix.sch, power.sch, replacement_kinesis_controller.sch, usb_connector.sch]
2015-02-22 Spread out components
    [replacement_kinesis_controller.kicad_pcb]
2015-02-22 Matrix connectors in place
    [replacement_kinesis_controller.kicad_pcb]
2015-02-22 Add component footprint map
2015-02-22 Add RGB LEDs
    [replacement_kinesis_controller.kicad_pcb]
2015-02-22 Add RGB LED footprint
2015-02-22 Some changes to PCB
    [replacement_kinesis_controller.kicad_pcb]
2015-02-22 WT12 breakout headers are now in place
    [bluetooth.sch, breakouts.sch, matrix.sch, power.sch, replacement_kinesis_controller.kicad_pcb, replacement_kinesis_controller.sch, usb_connector.sch]
2015-02-23 Add footprints to regular diodes
    [breakouts.sch, replacement_kinesis_controller.kicad_pcb, replacement_kinesis_controller.sch]
2015-02-23 Add regular LED footprints
    [bluetooth.sch, power.sch, replacement_kinesis_controller.sch]
2015-02-23 Add diode footprints
2015-02-23 More footprints
    [bluetooth.sch, breakouts.sch, power.sch]
2015-02-23 Add modules for vertical USB connectors
2015-02-23 Add usb footprints
    [usb_connector.sch]
2015-02-23 Move footprints around
    [replacement_kinesis_controller.kicad_pcb]
2015-02-23 Add mockup of USB breakout
    [replacement_kinesis_controller.kicad_pcb]
2015-02-24 Add more footprint mappings
    [power.sch, replacement_kinesis_controller.sch]
2015-02-24 Add WT12 footprint
    [bluetooth.sch, replacement_kinesis_controller.kicad_pcb]
2015-02-24 Basically done footprint assignment now...?
    [bluetooth.sch, power.sch, replacement_kinesis_controller.sch]
2015-02-24 Load last set of footprints
    [replacement_kinesis_controller.kicad_pcb]
2015-02-24 Fix WT12 footprint
    [replacement_kinesis_controller.kicad_pcb]
2015-02-24 A bunch of footprint arranging
    [bluetooth.sch, breakouts.sch, power.sch, replacement_kinesis_controller.kicad_pcb, replacement_kinesis_controller.sch]
2015-02-24 Add netlist in case it is important to track, even though it is auto generated
2015-02-25 Started laying some tracks
    [replacement_kinesis_controller.kicad_pcb]
2015-02-26 Ran a bunch of IO expander matrix tracks
    [replacement_kinesis_controller.kicad_pcb]
2015-02-26 Right half of matrix basically done
    [replacement_kinesis_controller.kicad_pcb]
2015-02-26 Power supply and LED tracks placed
    [replacement_kinesis_controller.kicad_pcb]
2015-02-27 Ran a bunch of tracks for the 32u4
    [breakouts.sch, replacement_kinesis_controller.kicad_pcb]
2015-02-27 More 32u4 traces
    [replacement_kinesis_controller.kicad_pcb]
2015-02-27 Some left matrix traces
    [replacement_kinesis_controller.kicad_pcb]
2015-02-27 Matrix and WT12 basically done
    [replacement_kinesis_controller.kicad_pcb]
2015-02-28 More WT12 wiring
    [replacement_kinesis_controller.kicad_pcb]
2015-03-03 Initial run of I2C lines
    [replacement_kinesis_controller.kicad_pcb]
2015-03-04 Rearranged some traces
    [replacement_kinesis_controller.kicad_pcb]
2015-03-04 Shoehorned another cap into the 32u4 breakout area
    [replacement_kinesis_controller.kicad_pcb]
2015-03-04 Add power switch connectors
    [replacement_kinesis_controller.kicad_pcb]
2015-03-07 Update bom and add a bunch of layout stuff
    [replacement_kinesis_controller.kicad_pcb]
2015-03-07 A bunch more rejiggering
    [replacement_kinesis_controller.kicad_pcb]
2015-03-08 More traces laid
    [replacement_kinesis_controller.kicad_pcb, replacement_kinesis_controller.sch, usb_connector.sch]
2015-03-08 Add a bunch of breakout boards in dead space
    [replacement_kinesis_controller.kicad_pcb]
2015-03-08 Fix edge cuts
    [replacement_kinesis_controller.kicad_pcb]
2015-03-08 Fixed mounting slot positions
    [replacement_kinesis_controller.kicad_pcb]
2015-03-08 Moved edge traces slightly more inbound
    [replacement_kinesis_controller.kicad_pcb]
2015-03-13 Round corners of breakout boards and add mouse bites
    [replacement_kinesis_controller.kicad_pcb]
2015-03-13 Round corners of main PCB
    [replacement_kinesis_controller.kicad_pcb]
2015-03-14 Lots of adjustments to fit in ground pour
    [replacement_kinesis_controller.kicad_pcb]
2015-03-14 Fix bluetooth breakout pin nets and add ground pour to USB boards
    [bluetooth.sch, breakouts.sch, power.sch, replacement_kinesis_controller.kicad_pcb]
2015-03-14 Add breakout for LED chain output
    [bluetooth.sch, breakouts.sch, power.sch, replacement_kinesis_controller.kicad_pcb, replacement_kinesis_controller.sch]
2015-03-14 Clean up silk screen, etc.
    [replacement_kinesis_controller.kicad_pcb]
2015-03-14 Add a bunch of silk screen stuff
    [replacement_kinesis_controller.kicad_pcb]
2015-03-15 More silkscreen stuff
    [replacement_kinesis_controller.kicad_pcb]
2015-03-15 Rearrange stuff so as to breakout IO expander pins
    [replacement_kinesis_controller.kicad_pcb]
2015-03-15 Add labels for IO expander breakout pins
    [replacement_kinesis_controller.kicad_pcb]
2015-03-15 Remove most solder jumpers
    [bluetooth.sch, breakouts.sch, power.sch, replacement_kinesis_controller.kicad_pcb, replacement_kinesis_controller.sch]
2015-03-15 Fix USB pin order on main connector
    [replacement_kinesis_controller.kicad_pcb, replacement_kinesis_controller.sch]
2015-03-15 Remove last solder jumper from PCB
    [replacement_kinesis_controller.kicad_pcb]
2015-03-15 Label reset switches on silk screen
    [replacement_kinesis_controller.kicad_pcb]
2015-03-15 Rejigger things to make board more easily separable
    [replacement_kinesis_controller.kicad_pcb]
2015-03-18 A bunch of silkscreen improvements
    [replacement_kinesis_controller.kicad_pcb]
2015-03-18 Update sot23-5 footprint for handsoldering
    [replacement_kinesis_controller.kicad_pcb]
2015-03-18 More silk updates and another WS2811 breakout
    [power.sch, replacement_kinesis_controller.kicad_pcb]
2015-03-18 Remove matrix breakout connectors
    [breakouts.sch, replacement_kinesis_controller.kicad_pcb]
2015-03-19 Add some perfboard in dead space
    [replacement_kinesis_controller.kicad_pcb]
2015-03-19 Add perf board footprint
2015-03-19 Change via drill size
    [replacement_kinesis_controller.kicad_pcb]
2015-03-19 Increase diode pad size for handsoldering
    [replacement_kinesis_controller.kicad_pcb]
2015-03-20 Resize one text element to fit a bit cleaner
    [replacement_kinesis_controller.kicad_pcb]
2015-03-22 Add slots to drill layer
    [replacement_kinesis_controller.kicad_pcb]
